Ardentis-sd/XiBank/ProductionFiles/BOM/2022-09-08_BOM_XiBank_V1.0_(Default).xlsx

Designator | Quantity | Manufacturer Part Number | Description | Manufacturer | Value | Footprint
C1, C2, C10 | 3 | CL21A106KAYNNNE | 10 µF ±10% 25V Ceramic Capacitor X5R 0805 (2012 Metric) | Samsung Electro-Mechanics | 10u | CC0805
C3, C4, C11 | 3 | CL10B104KB8NNNC | 0.1 µF ±10% 50V Ceramic Capacitor X7R 0603 (1608 Metric) | Samsung Electro-Mechanics | 100n | CC0603
C5, C6, C7, C8, C9 | 5 | CL21A226MAYNNNE | 22 µF ±20% 25V Ceramic Capacitor X5R 0805 (2012 Metric) | Samsung Electro-Mechanics | 22u | CC0805
C12, C13, C14, C15 | 4 | CL21A226MOCLRNC | 22 µF ±20% 16V Ceramic Capacitor X5R 0805 (2012 Metric) | Samsung Electro-Mechanics | 22u | CC0805
C16, C17 | 2 | CL10A225KO8NNNC | 2.2 µF ±10% 16V Ceramic Capacitor X5R 0603 (1608 Metric) | Samsung Electro-Mechanics | 2.2uF | CC0603
D1, D2, D3, D4, D5 | 5 | LTW-C191DS5 | White LED Indication - Discrete 2.93V 0603 (1608 Metric) | Lite-On Inc. |  | LED0603
L1 | 1 | HPI1040-2R2 | SMD Power Inductor, 2.2uH, 12A, 6.5mΩ | FERROCORE | 2.2 uH | HPI1040100
Q1 | 1 | IRLML6402TRPBF | P-Channel 20 V 3.7A (Ta) 1.3W (Ta) Surface Mount Micro3™/SOT-23 | Infineon Technologies |  | SOT23-3
Q2, Q3 | 2 | AO3416 | N-Channel 20 V 6.5A (Ta) 1.4W (Ta) Surface Mount SOT-23-3 | Alpha & Omega Semiconductor Inc. |  | SOT23-3
R1, R2, R3 | 3 | RC0603FR-07100RL | 100 ±1% 0.1W, 1/10W Chip Resistor 0603 (1608 Metric) Moisture Resistant Thick Film | YAGEO | 100R | RC0603
R4 | 1 | RC0603FR-071KL | 1k ±1% 0.1W, 1/10W Chip Resistor 0603 (1608 Metric) Moisture Resistant Thick Film | YAGEO | 1k | RC0603
R5 | 1 | RC0603FR-0782KL | 82 kOhms ±1% 0.1W, 1/10W Chip Resistor 0603 (1608 Metric) Moisture Resistant Thick Film | YAGEO | 82k | RC0603
R7 | 1 | RC0603FR-07169KL | 169k ±1% 0.1W, 1/10W Chip Resistor 0603 (1608 Metric) Moisture Resistant Thick Film | YAGEO | 169k | RC0603
R8 | 1 | RL1206FR-070R01L | 10 mOhms ±1% 0.25W, 1/4W Chip Resistor 1206 (3216 Metric) Automotive AEC-Q200, Current Sense, Moisture Resistant Thick Film | YAGEO | 0.01R | RC1206
R9 | 1 | RC0603FR-0710KL | 10k ±1% 0.1W, 1/10W Chip Resistor 0603 (1608 Metric) Moisture Resistant Thick Film | YAGEO | 10k | RC0603
S1 | 1 | LS10N2T | Tactile Switch SPST-NO Side Actuated Surface Mount, Right Angle | Citizen |  | SW_LS10N2T_CIT
U1 | 1 | IP5328P | Fully-Integrated Bi-directional PD3.0 and Fast Charge Power Bank SOC with Multiple Input and Output Ports | INJOINIC Technology |  | QFN50P600X600X80-41N
XP1, XP2 | 2 | NULL | USB-A (USB TYPE-A) USB 2.0 Plug Connector 4 Position Surface Mount, Right Angle | NULL |  | 0480372200
XP3 | 1 | 10118194-0001LF | Micro USB B Right Angled Socket, SMD | FCI |  | 10118194-0001LF
