Ardentis-sd/XiBank/ProductionFiles/AssemblyDrawings/2022-09-08_AssemblyDrawings_XiBank_V1.0_(Default).PDF

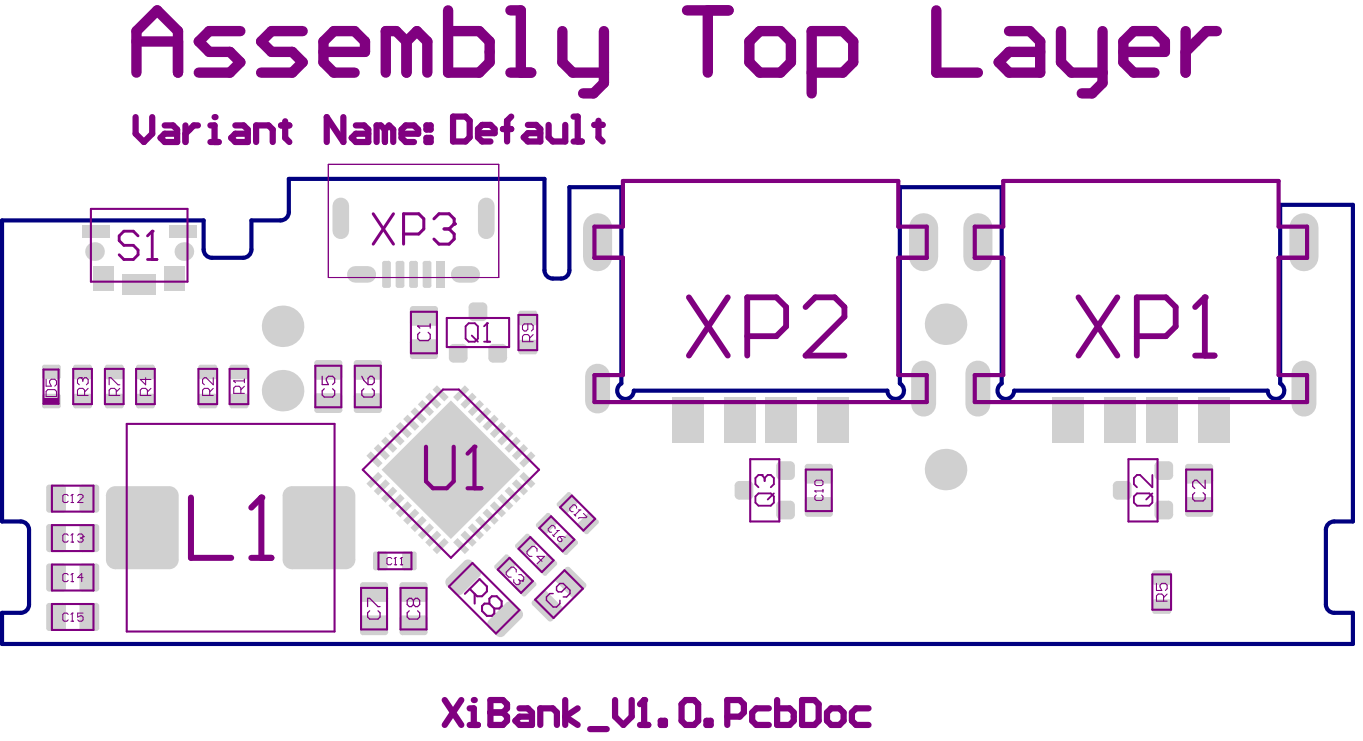
[picture p3: page 1]

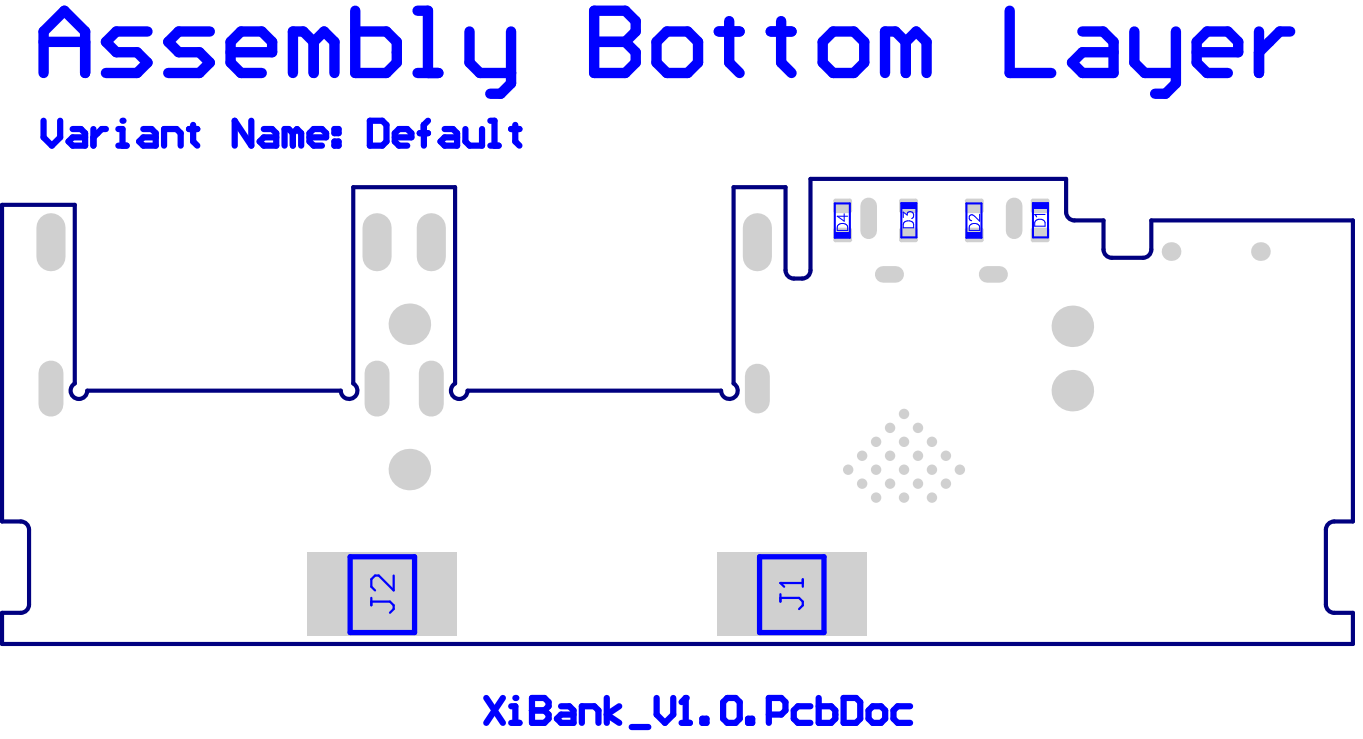
[picture p4: page 2]
