Ardentis-sd/XiBank/(list of files, drawings)

Other design files:
PCB/XiBank_V1.0.PcbDoc
PCB/XiBank_V1.0.PrjPcb
PCB/XiBank_V1.0.SchDoc
